Sp1kys/Sensorless_Coreless_motor_ESC_SimpleFOC/README.md

# SimpleFOC_Sensorless_Coreless_motor_ESC
 Hardware and software for Custom ESC for Coreless motors
