Sp1kys/Sensorless_Coreless_motor_ESC_SimpleFOC/Hardware/Small_ESC/Small_ESC.kicad_pcb

## KiCad design Hardware/Small_ESC/Small_ESC.kicad_pcb (2024-12-08)

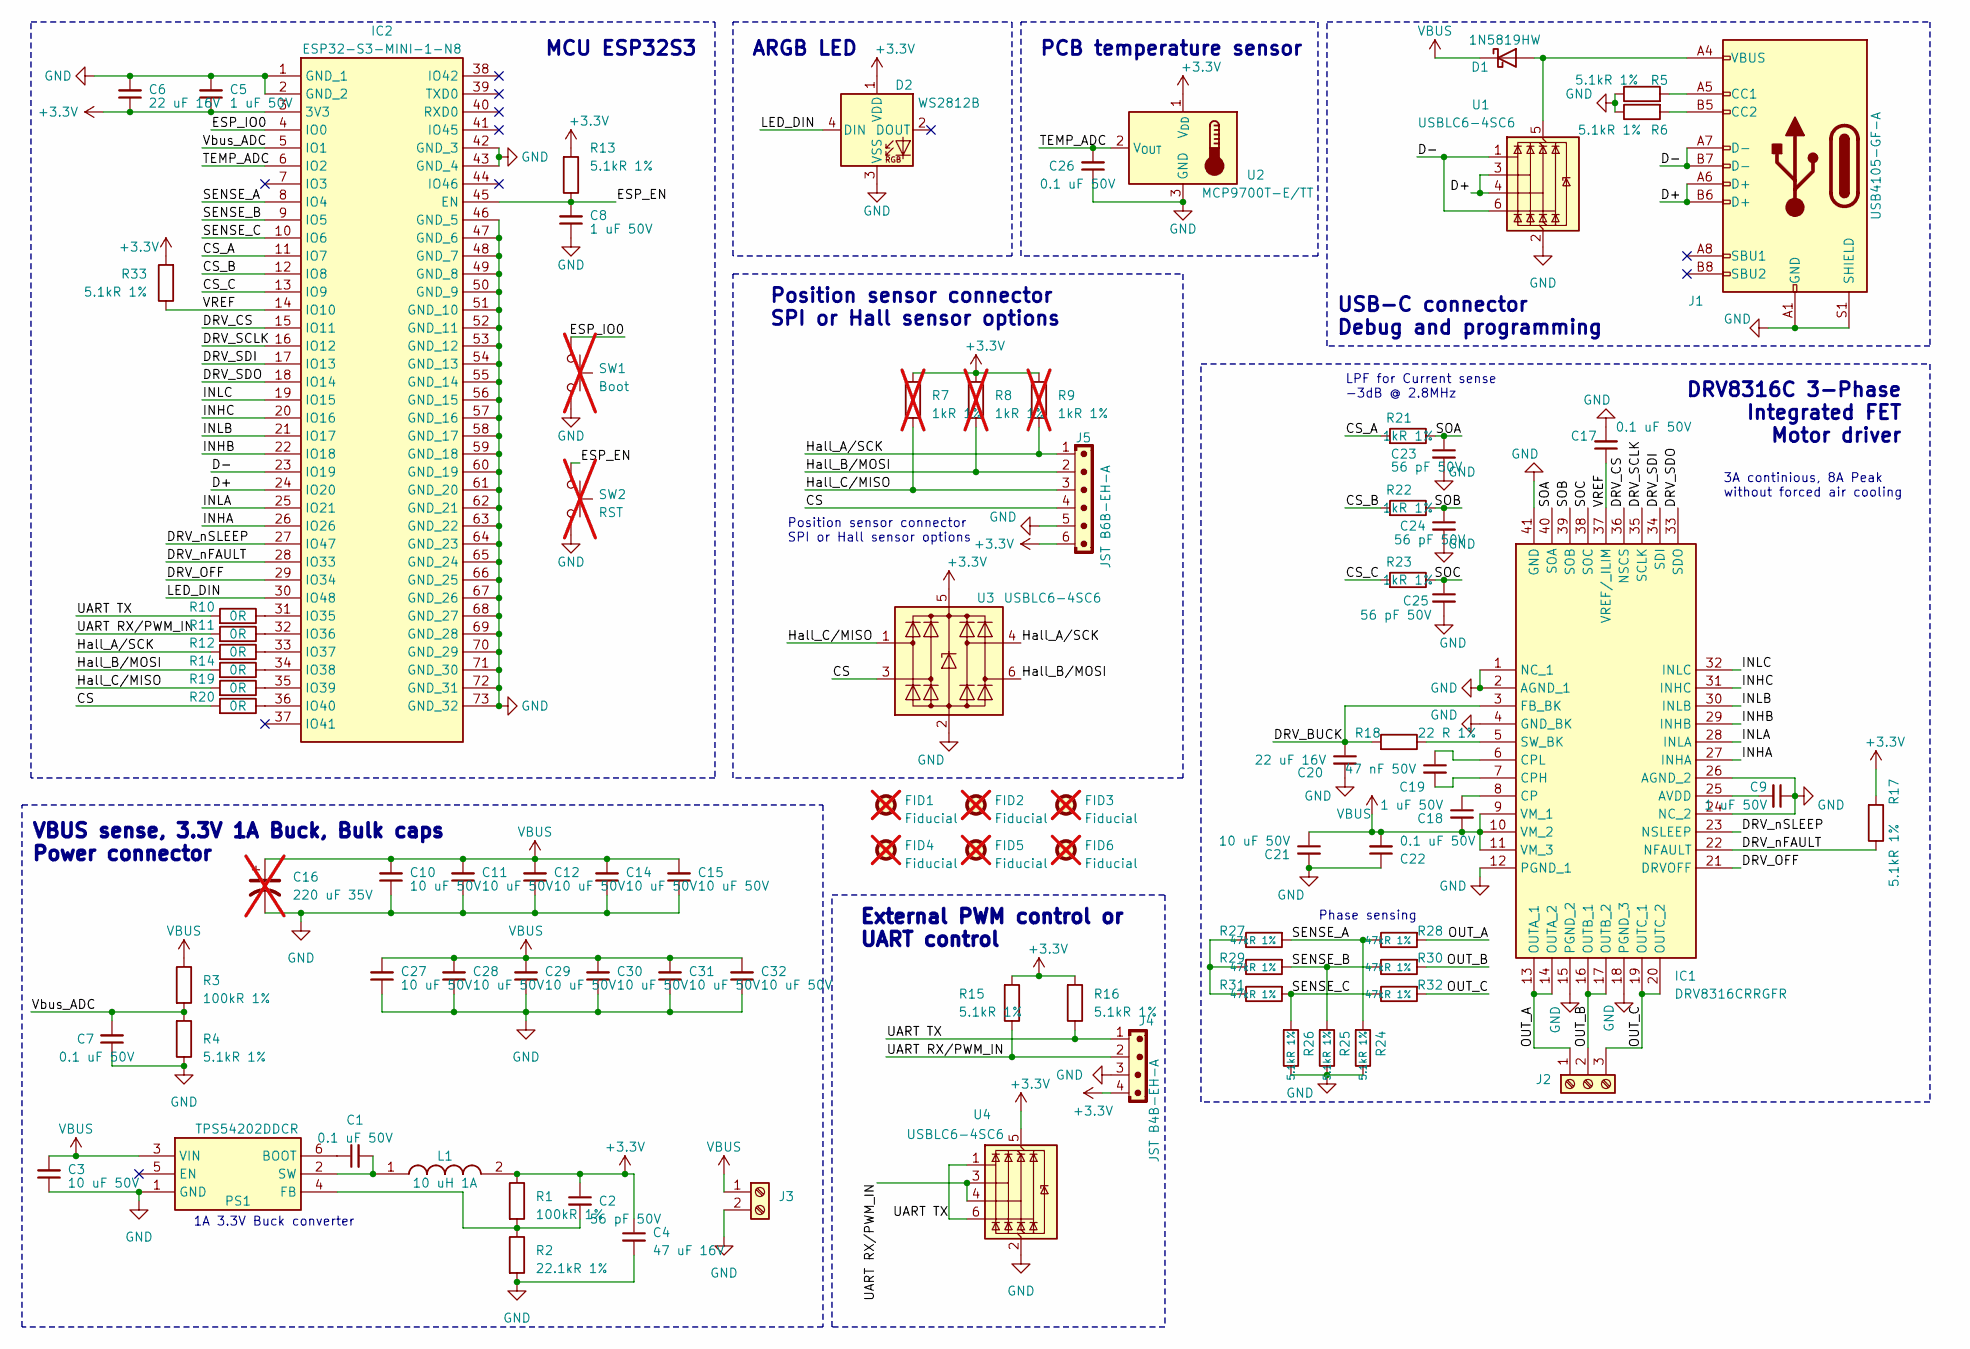
[picture p1: schematic Small_ESC.kicad_sch, Small PCB motor ESC]

Parts:
C1, C7, C17, C22, C26: 0.1 uF 50V; C_0402_1005Metric; Manufacturer_Part_Number GCM155R71H104KE02J
C2, C23, C24, C25: 56 pF 50V; C_0402_1005Metric; Manufacturer_Part_Number GCM1555C1H560JA16D
C3, C10, C11, C12, C14, C15, C21, C27, C28, C29, C30, C31, C32: 10 uF 50V; C_0805_2012Metric; Manufacturer_Part_Number GRM21BR61H106KE43L
C4: 47 uF 16V; C_1210_3225Metric; Manufacturer_Part_Number CL32A476KOJNNNE
C5, C8, C9, C18: 1 uF 50V; C_0603_1608Metric; Manufacturer_Part_Number CL10A105KB8NNNC
C6, C20: 22 uF 16V; C_0805_2012Metric; Manufacturer_Part_Number CL21A226MOCLRNC
C16: 220 uF 35V; C_Rect_L7.0mm_W3.5mm_P5.00mm; not fitted
C19: 47 nF 50V; C_0402_1005Metric; Manufacturer_Part_Number GRM155R71H473KE14D
D1: 1N5819HW; D_SOD-123; Manufacturer_Part_Number 1N5819HW-7-F
D2: WS2812B; LED_WS2812B_PLCC4_5.0x5.0mm_P3.2mm; Manufacturer_Part_Number WS2812B-B/T
FID1, FID2, FID3, FID4, FID5, FID6: Fiducial; Fiducial_0.75mm_Mask1.5mm; not fitted
IC1: DRV8316CRRGFR; QFN50P500X700X100-41N-D; Mouser Part Number 595-DRV8316CRRGFR
IC2: ESP32-S3-MINI-1-N8; ESP32S3MINI1N8; Mouser Part Number 356-ESP32-S3-MINI1N8
J1: USB4105-GF-A; USB_C_Receptacle_GCT_USB4105-xx-A_16P_TopMnt_Horizontal; Manufacturer_Part_Number USB4105-GF-A
J2: PT-1,5-3-3.5-H; TerminalBlock_Phoenix_PT-1,5-3-3.5-H_1x03_P3.50mm_Horizontal; Manufacturer_Part_Number 1984620
J3: PT-1,5-2-3.5-H; TerminalBlock_Phoenix_PT-1,5-2-3.5-H_1x02_P3.50mm_Horizontal; Manufacturer_Part_Number 1984617
J4: JST B4B-EH-A; JST_EH_B4B-EH-A_1x04_P2.50mm_Vertical; Manufacturer_Part_Number B4B-EH-A
J5: JST B6B-EH-A; JST_EH_B6B-EH-A_1x06_P2.50mm_Vertical; Manufacturer_Part_Number B6B-EH-A
L1: 10 uH 1A; VLS3015; Mouser Part Number 810-VLS3015CX-100M-H
PS1: TPS54202DDCR; SOT95P280X110-6N; Mouser Part Number 595-TPS54202DDCR
R1, R3: 100kR 1%; R_0402_1005Metric; Manufacturer_Part_Number ERJ-2RKF1003X
R2: 22.1kR 1%; R_0402_1005Metric; Manufacturer_Part_Number ERJ-2RKF2212X
R4, R5, R6, R13, R15, R16, R17, R24, R25, R26, R33: 5.1kR 1%; R_0402_1005Metric; Manufacturer_Part_Number ERJ-2RKF5101X
R7, R8, R9: 1kR 1%; R_0402_1005Metric; Manufacturer_Part_Number ERJ-2RKF1001X; not fitted
R10, R11, R12, R14, R19, R20: 0R; R_0402_1005Metric; Manufacturer_Part_Number RC0402JR-070RL
R18: 22 R 1%; R_0805_2012Metric; Manufacturer_Part_Number ERJ-6ENF22R0V
R21, R22, R23: 1kR 1%; R_0402_1005Metric; Manufacturer_Part_Number ERJ-2RKF1001X
R27, R28, R29, R30, R31, R32: 47kR 1%; R_0402_1005Metric; Manufacturer_Part_Number ERJ-2RKF4702X
SW1: Boot; PinHeader_1x02_P2.54mm_Vertical; not fitted
SW2: RST; PinHeader_1x02_P2.54mm_Vertical; not fitted
U1, U3, U4: USBLC6-4SC6; SOT-23-6; Manufacturer_Part_Number USBLC6-4SC6
U2: MCP9700T-E/TT; SOT-23; Manufacturer_Part_Number MCP9700T-E/TT

Connections:
+3.3V: C2.1, C4.1, C5.1, C6.1, D2.1 (VDD), IC2.3 (3V3), J4.4, J5.6, L1.2, R1.1, R7.1, R8.1, R9.1, R13.2, R15.2, R16.2, R17.2, R33.2, U2.1 (V_{DD}), U3.5 (VBUS), U4.5 (VBUS)
/CS: J5.4, R20.2, U3.3 (I/O2)
/CS_A: IC2.11 (IO7), R21.2
/CS_B: IC2.12 (IO8), R22.2
/CS_C: IC2.13 (IO9), R23.2
/D+: IC2.24 (IO20), J1.A6 (D+), J1.B6 (D+), U1.3 (I/O2), U1.4 (I/O3)
/D-: IC2.23 (IO19), J1.A7 (D-), J1.B7 (D-), U1.1 (I/O1), U1.6 (I/O4)
/DRV_BUCK: C20.1, IC1.3 (FB_BK), R18.2
/DRV_CS: IC1.36 (NSCS), IC2.15 (IO11)
/DRV_OFF: IC1.21 (DRVOFF), IC2.29 (IO34)
/DRV_SCLK: IC1.35 (SCLK), IC2.16 (IO12)
/DRV_SDI: IC1.34 (SDI), IC2.17 (IO13)
/DRV_SDO: IC1.33 (SDO), IC2.18 (IO14)
/DRV_nFAULT: IC1.22 (NFAULT), IC2.28 (IO33), R17.1
/DRV_nSLEEP: IC1.23 (NSLEEP), IC2.27 (IO47)
/ESP_EN: C8.2, IC2.45 (EN), R13.1, SW2.1
/ESP_IO0: IC2.4 (IO0), SW1.1
/Hall_A/SCK: J5.1, R9.2, R12.2, U3.4 (I/O3)
/Hall_B/MOSI: J5.2, R8.2, R14.2, U3.6 (I/O4)
/Hall_C/MISO: J5.3, R7.2, R19.2, U3.1 (I/O1)
/INHA: IC1.27 (INHA), IC2.26 (IO26)
/INHB: IC1.29 (INHB), IC2.22 (IO18)
/INHC: IC1.31 (INHC), IC2.20 (IO16)
/INLA: IC1.28 (INLA), IC2.25 (IO21)
/INLB: IC1.30 (INLB), IC2.21 (IO17)
/INLC: IC1.32 (INLC), IC2.19 (IO15)
/LED_DIN: D2.4 (DIN), IC2.30 (IO48)
/OUT_A: IC1.13 (OUTA_1), IC1.14 (OUTA_2), J2.1, R28.2
/OUT_B: IC1.16 (OUTB_1), IC1.17 (OUTB_2), J2.2, R30.2
/OUT_C: IC1.19 (OUTC_1), IC1.20 (OUTC_2), J2.3, R32.2
/SENSE_A: IC2.8 (IO4), R24.2, R27.2, R28.1
/SENSE_B: IC2.9 (IO5), R25.2, R29.2, R30.1
/SENSE_C: IC2.10 (IO6), R26.2, R31.2, R32.1
/SOA: C23.1, IC1.40 (SOA), R21.1
/SOB: C24.1, IC1.39 (SOB), R22.1
/SOC: C25.1, IC1.38 (SOC), R23.1
/TEMP_ADC: C26.2, IC2.6 (IO2), U2.2 (V_{OUT})
/UART RX/PWM_IN: J4.2, R11.2, R15.1, U4.3 (I/O2), U4.4 (I/O3)
/UART TX: J4.1, R10.2, R16.1, U4.1 (I/O1), U4.6 (I/O4)
/VREF: C17.1, IC1.37 (VREF/_ILIM), IC2.14 (IO10), R33.1
/Vbus_ADC: C7.2, IC2.5 (IO1), R3.2, R4.2
GND: C3.1, C4.2, C5.2, C6.2, C7.1, C8.1, C9.1, C10.1, C11.1, C12.1, C14.1, C15.1, C16.2, C17.2, C20.2, C21.2, C22.1, C23.2, C24.2, C25.2, C26.1, C27.1, C28.1, C29.1, C30.1, C31.1, C32.1, D2.3 (VSS), IC1.1 (NC_1), IC1.2 (AGND_1), IC1.4 (GND_BK), IC1.12 (PGND_1), IC1.15 (PGND_2), IC1.18 (PGND_3), IC1.24 (NC_2), IC1.26 (AGND_2), IC1.41 (GND), IC2.1 (GND_1), IC2.2 (GND_2), IC2.42 (GND_3), IC2.43 (GND_4), IC2.46 (GND_5), IC2.47 (GND_6), IC2.48 (GND_7), IC2.49 (GND_8), IC2.50 (GND_9), IC2.51 (GND_10), IC2.52 (GND_11), IC2.53 (GND_12), IC2.54 (GND_13), IC2.55 (GND_14), IC2.56 (GND_15), IC2.57 (GND_16), IC2.58 (GND_17), IC2.59 (GND_18), IC2.60 (GND_19), IC2.61 (GND_20), IC2.62 (GND_21), IC2.63 (GND_22), IC2.64 (GND_23), IC2.65 (GND_24), IC2.66 (GND_25), IC2.67 (GND_26), IC2.68 (GND_27), IC2.69 (GND_28), IC2.70 (GND_29), IC2.71 (GND_30), IC2.72 (GND_31), IC2.73 (GND_32), J1.A1 (GND), J1.A12 (GND), J1.B1 (GND), J1.B12 (GND), J1.S1 (SHIELD), J3.2, J4.3, J5.5, PS1.1 (GND), R2.2, R4.1, R5.1, R6.1, R24.1, R25.1, R26.1, SW1.2, SW2.2, U1.2 (GND), U2.3 (GND), U3.2 (GND), U4.2 (GND)
unnamed: D1.2 (A), J1.A4 (VBUS), J1.A9 (VBUS), J1.B4 (VBUS), J1.B9 (VBUS), U1.5 (VBUS)
unnamed: C9.2, IC1.25 (AVDD)
unnamed: C18.1, IC1.8 (CP)
unnamed: C19.2, IC1.7 (CPH)
unnamed: C19.1, IC1.6 (CPL)
unnamed: IC1.5 (SW_BK), R18.1
unnamed: IC2.31 (IO35), R10.1
unnamed: IC2.32 (IO36), R11.1
unnamed: IC2.33 (IO37), R12.1
unnamed: IC2.34 (IO38), R14.1
unnamed: IC2.35 (IO39), R19.1
unnamed: IC2.36 (IO40), R20.1
unnamed: J1.A5 (CC1), R5.2
unnamed: J1.B5 (CC2), R6.2
unnamed: C1.1, PS1.6 (BOOT)
unnamed: C2.2, PS1.4 (FB), R1.2, R2.1
unnamed: C1.2, L1.1, PS1.2 (SW)
unnamed: R27.1, R29.1, R31.1
VBUS: C3.2, C10.2, C11.2, C12.2, C14.2, C15.2, C16.1, C18.2, C21.1, C22.2, C27.2, C28.2, C29.2, C30.2, C31.2, C32.2, D1.1 (K), IC1.9 (VM_1), IC1.10 (VM_2), IC1.11 (VM_3), J3.1, PS1.3 (VIN), R3.1

Notes on the sheet:
LPF for Current sense -3dB @ 2.8MHz
VBUS sense, 3.3V 1A Buck, Bulk caps Power connector
Position sensor connector SPI or Hall sensor options
ARGB LED
External PWM control or UART control
DRV8316C 3-Phase Integrated FET Motor driver
3A continious, 8A Peak without forced air cooling
Phase sensing
PCB temperature sensor
MCU ESP32S3
USB-C connector Debug and programming
1A 3.3V Buck converter

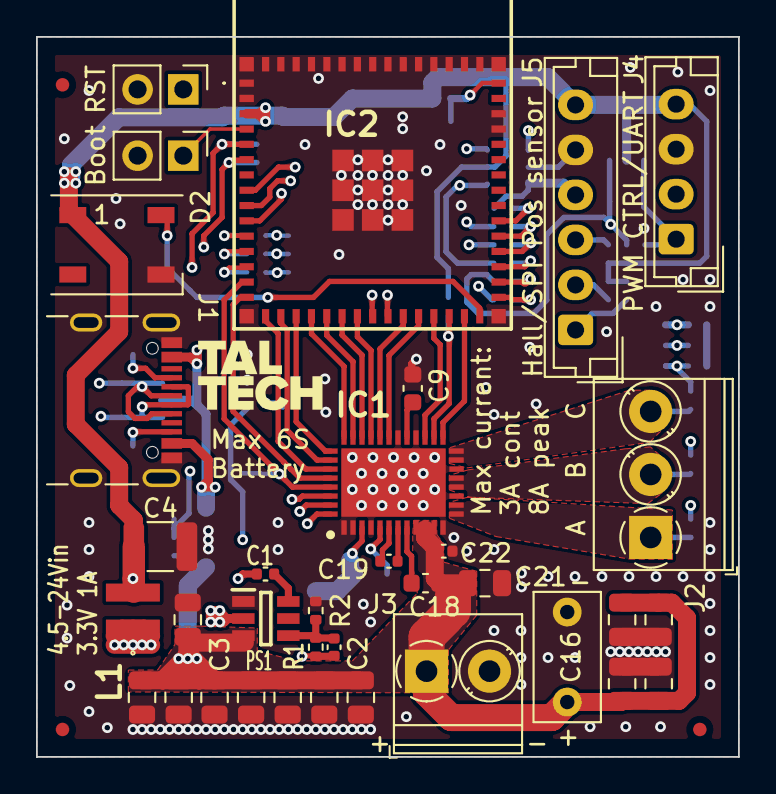
[picture p2: board Small_ESC.kicad_pcb from above]

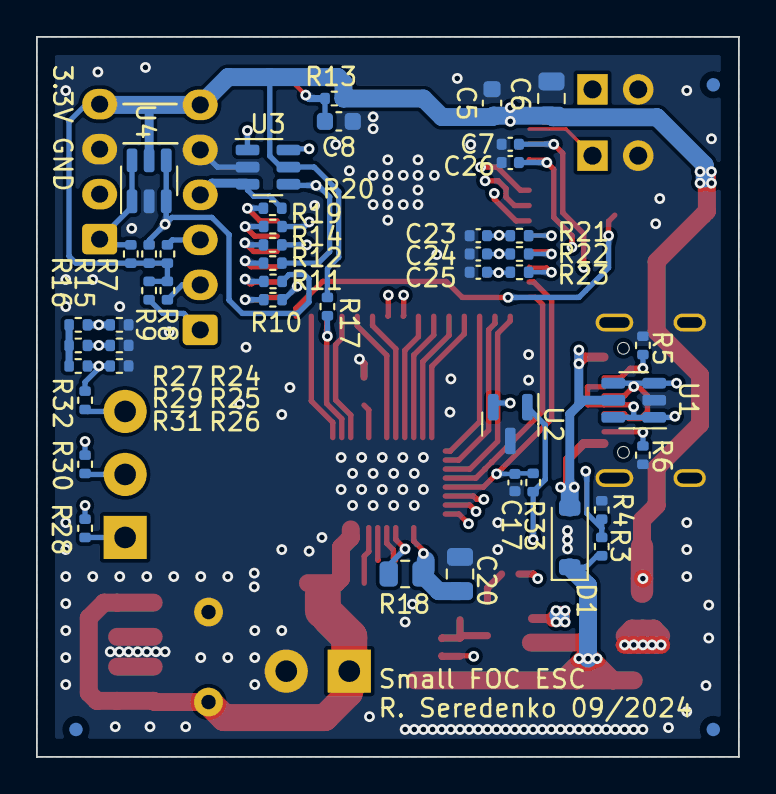
[picture p3: board Small_ESC.kicad_pcb from below]

Board: 4 copper layers, 39.0 x 40.0 mm, 87 parts (49 on the bottom side), 61 nets.
