Sp1kys/Sensorless_Coreless_motor_ESC_SimpleFOC/(commit log)

2024-12-08 Fix average value reporting and experimental motor resistance
    [main.cpp]
2024-12-08 PCB and SimpleFOC studio
    [Small_ESC-B_Cu.gbr, Small_ESC-B_Mask.gbr, Small_ESC-B_Paste.gbr, Small_ESC-B_SilkS.gbr, Small_ESC-Edge_Cuts.gbr, Small_ESC-F_Cu.gbr, Small_ESC-F_Mask.gbr, Small_ESC-F_Paste.gbr]
